H-Allen/HackTheBurgh/batfpga/confusion_matrix.png

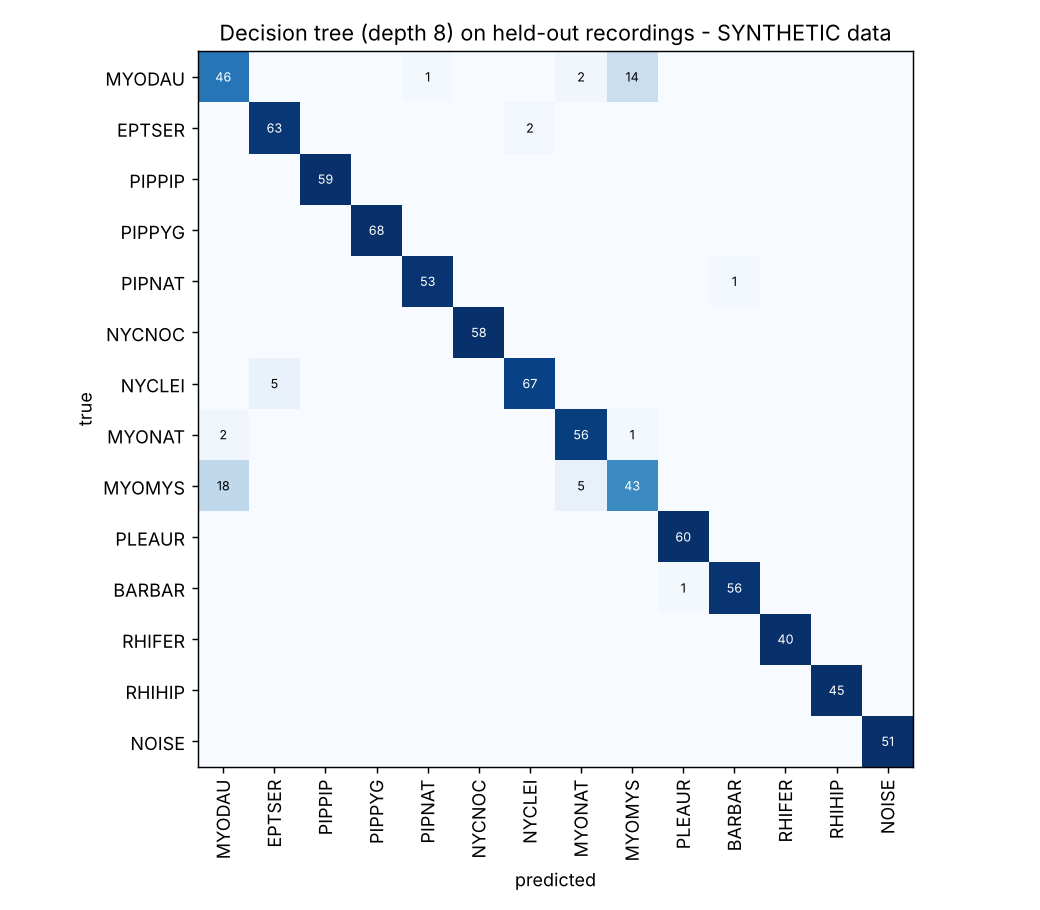
batfpga/confusion_matrix.png
