H-Allen/HackTheBurgh/batfpga/demo/presentation_audio/spectrogram_before_after.png

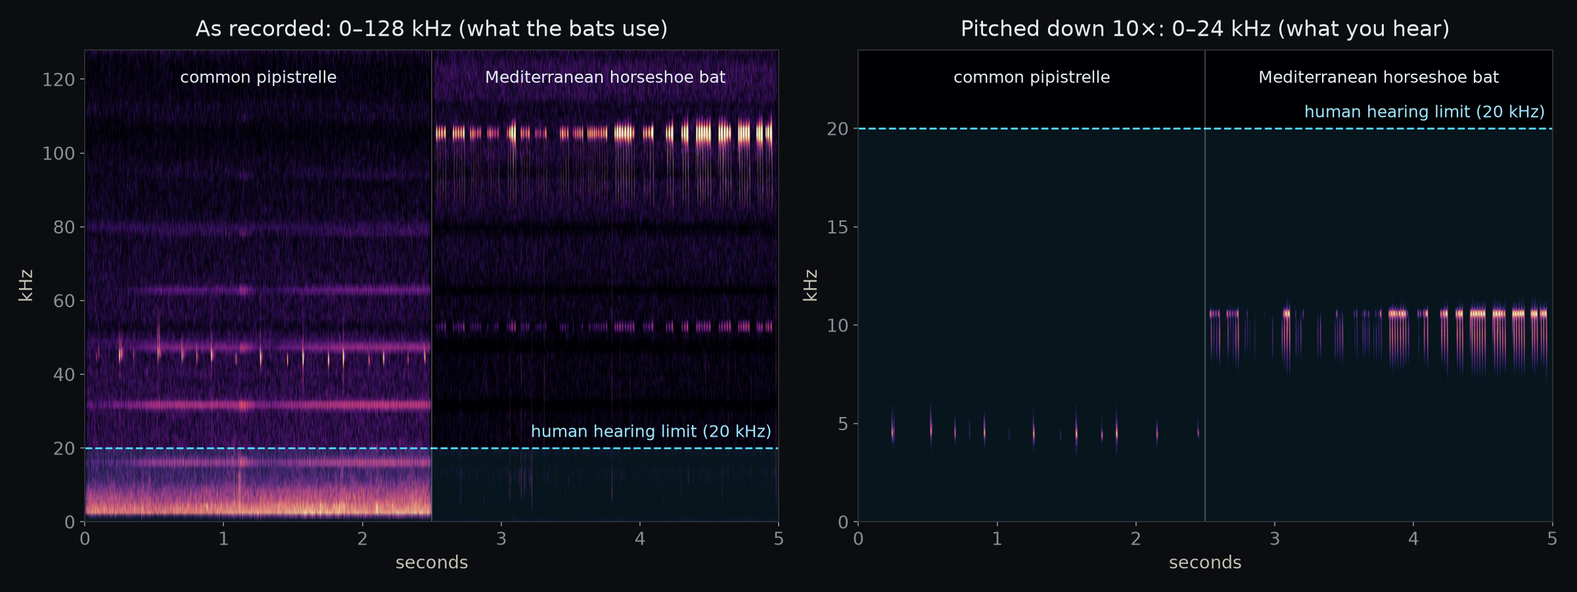
batfpga/demo/presentation_audio/spectrogram_before_after.png
