H-Allen/HackTheBurgh/batfpga/predict/figures/balkans/1_known_now.png

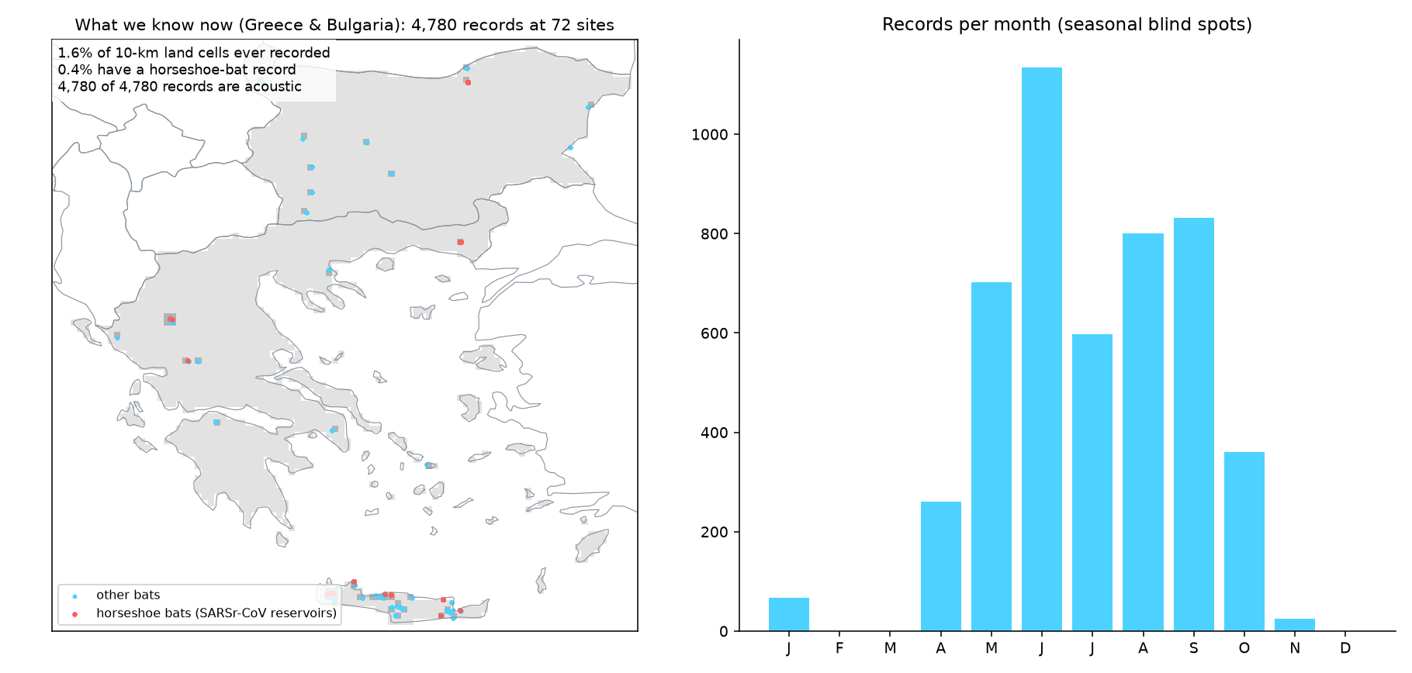
batfpga/predict/figures/balkans/1_known_now.png
