H-Allen/HackTheBurgh/batfpga/predict/figures/balkans/2_maps.png

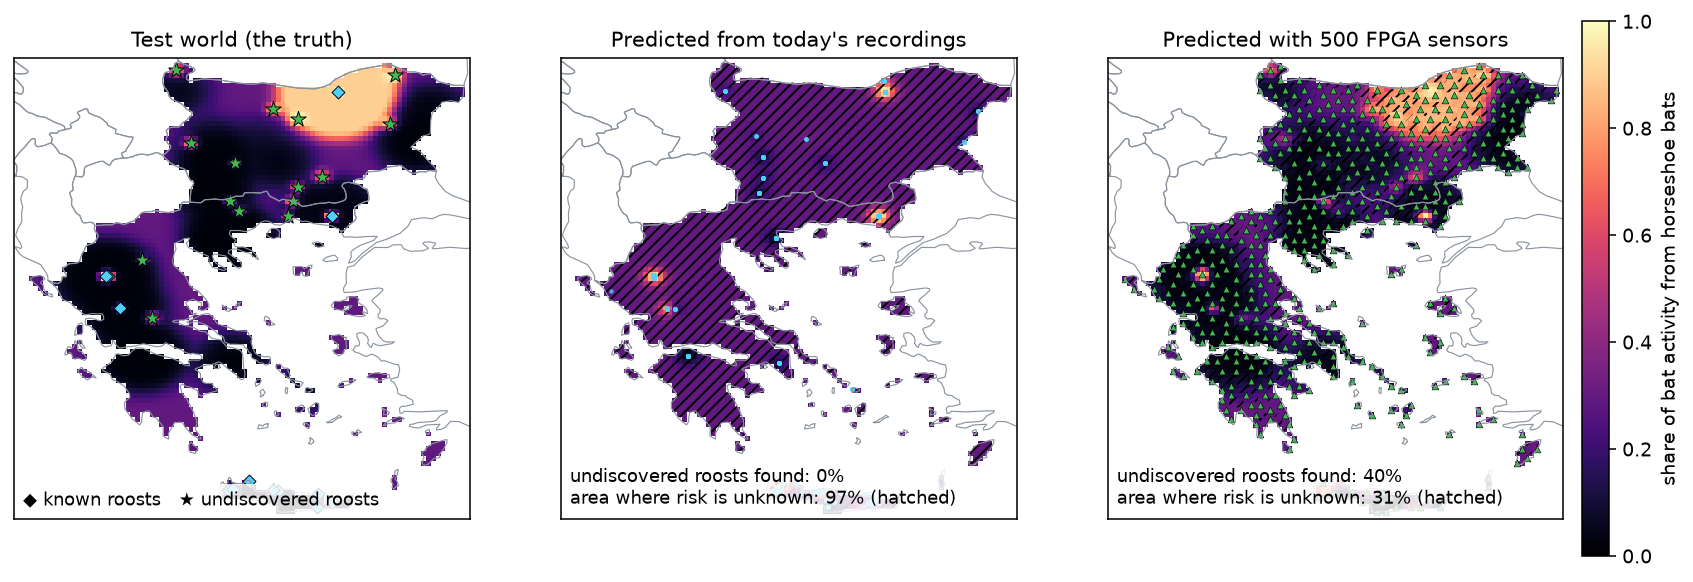
batfpga/predict/figures/balkans/2_maps.png
