H-Allen/HackTheBurgh/batfpga/predict/figures/balkans/3_curves.png

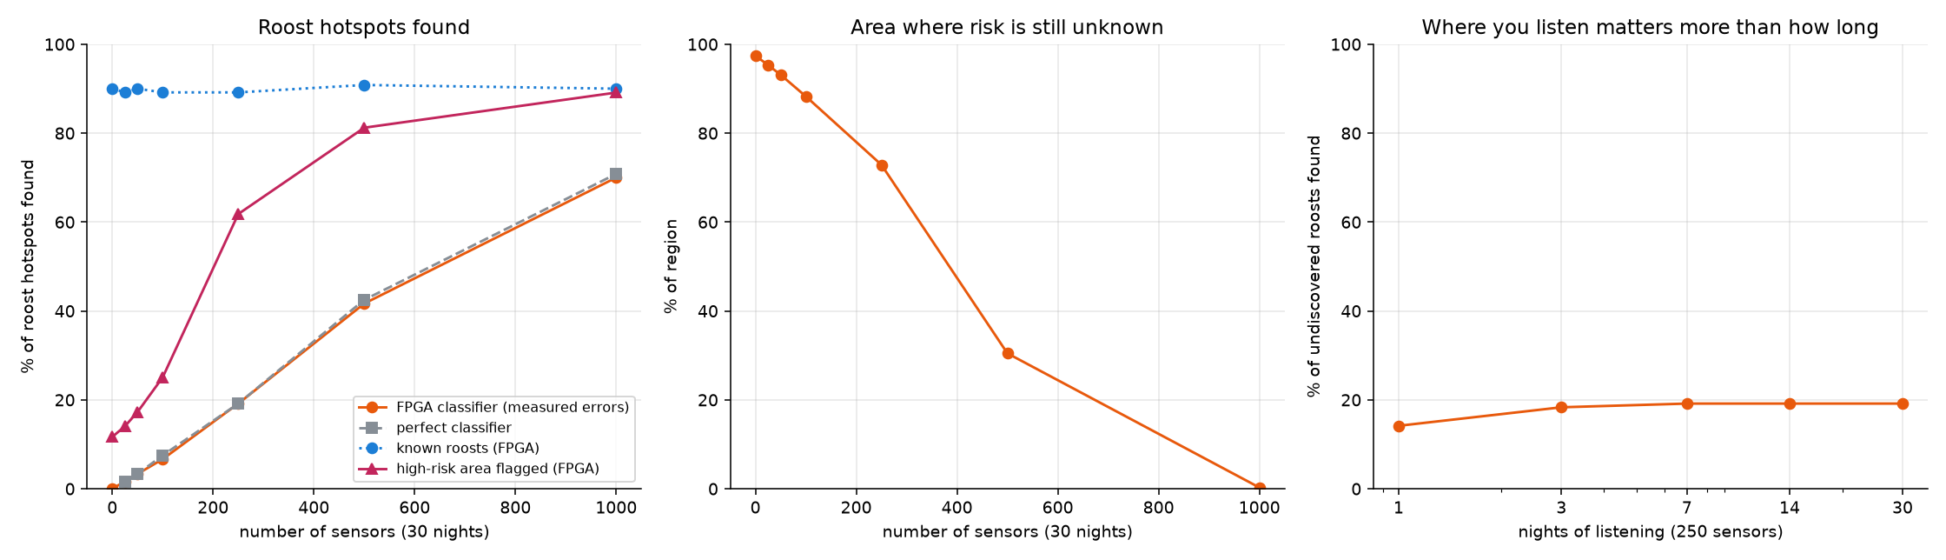
batfpga/predict/figures/balkans/3_curves.png
