H-Allen/HackTheBurgh/batfpga/predict/figures/sea/1_known_now.png

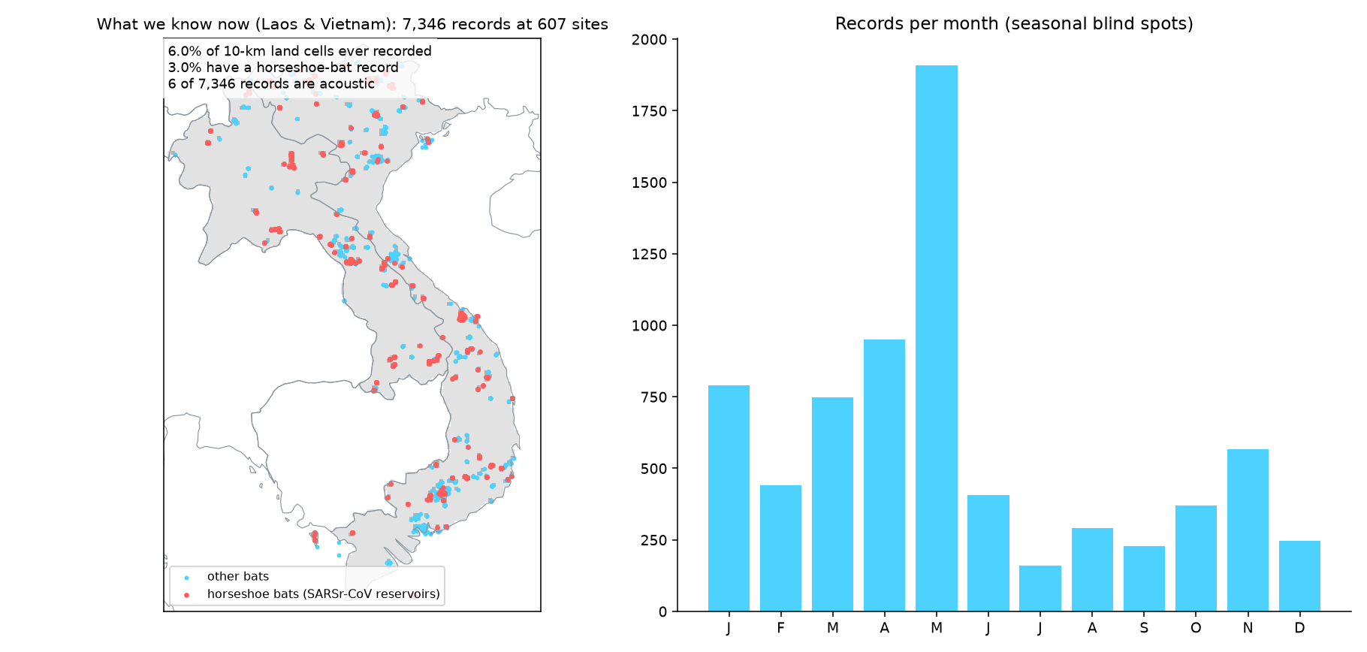
batfpga/predict/figures/sea/1_known_now.png
