H-Allen/HackTheBurgh/batfpga/predict/figures/sea/2_maps.png

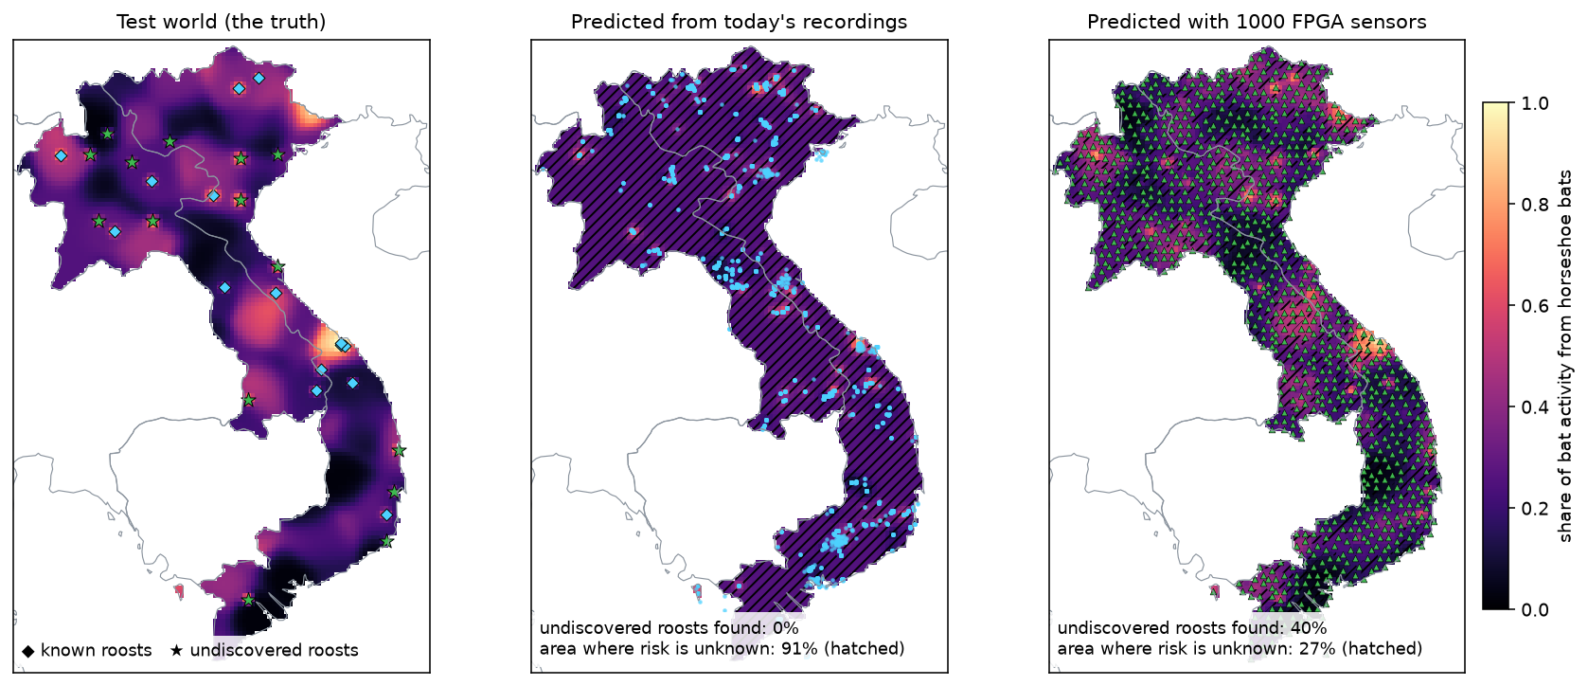
batfpga/predict/figures/sea/2_maps.png
