H-Allen/HackTheBurgh/batfpga/predict/figures/sea/3_curves.png

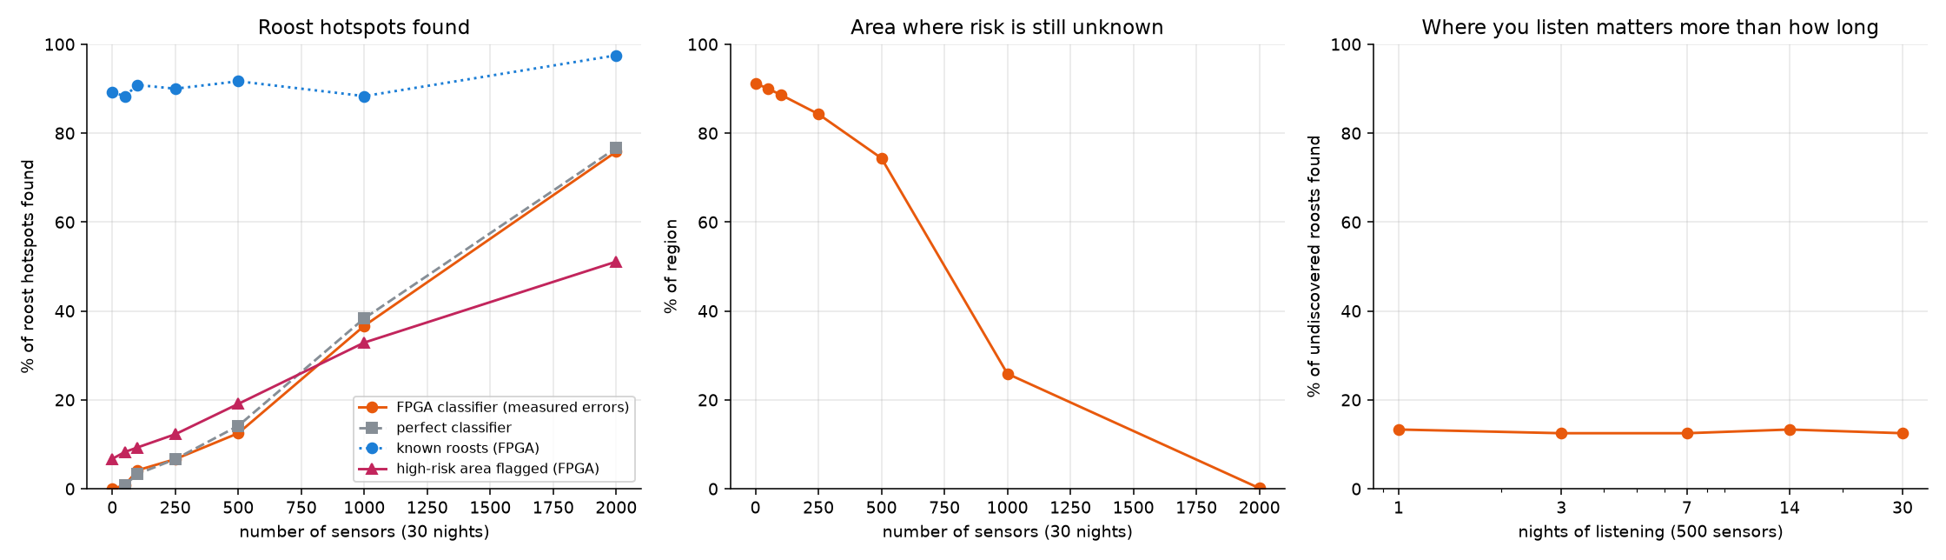
batfpga/predict/figures/sea/3_curves.png
