H-Allen/HackTheBurgh/batfpga/predict/viz/export/balkans/1_today.png

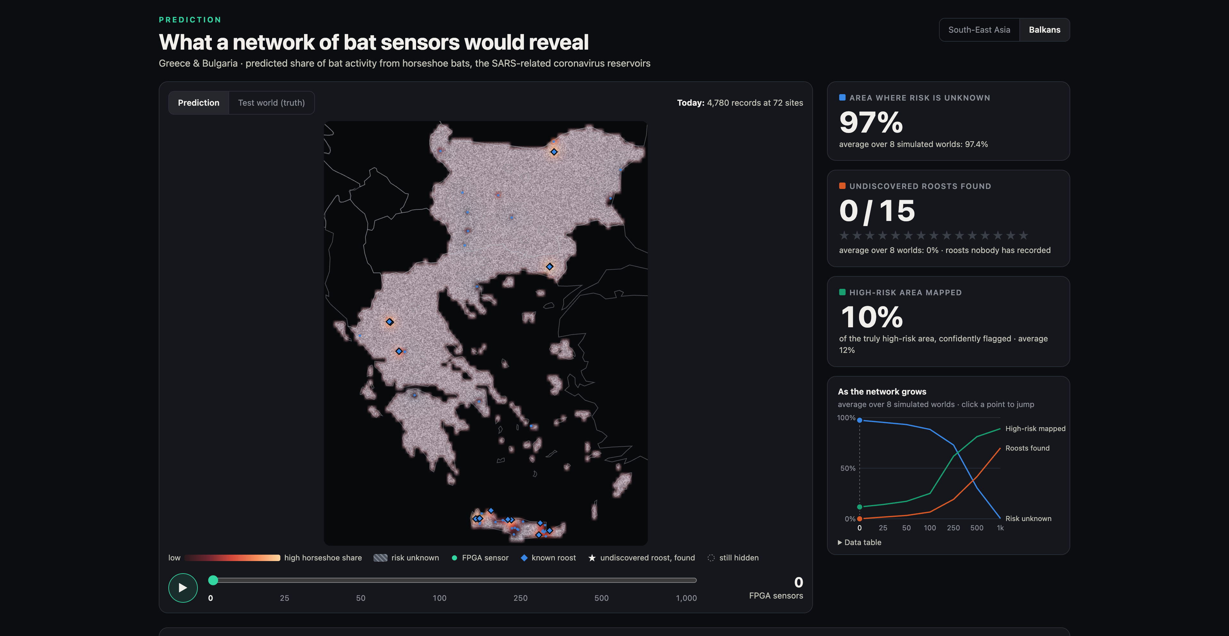
batfpga/predict/viz/export/balkans/1_today.png
