H-Allen/HackTheBurgh/batfpga/predict/viz/export/balkans/5_truth.png

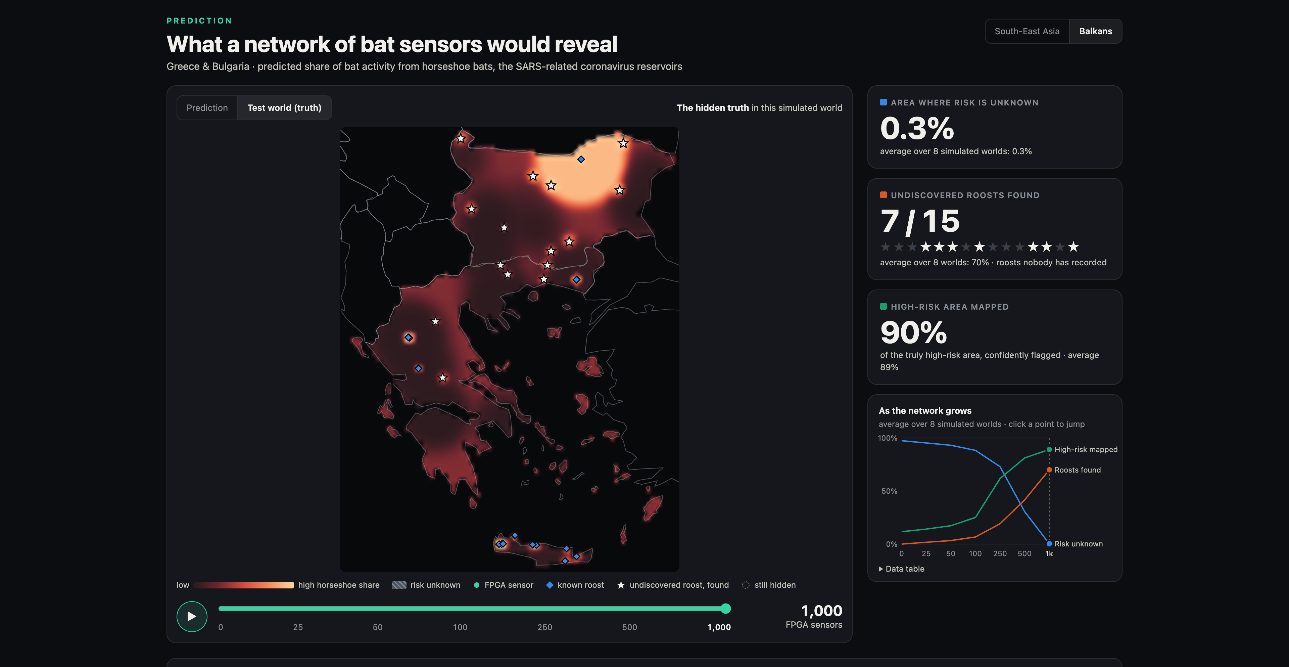
batfpga/predict/viz/export/balkans/5_truth.png
