H-Allen/HackTheBurgh/batfpga/predict/viz/export/balkans/network_reveal.gif

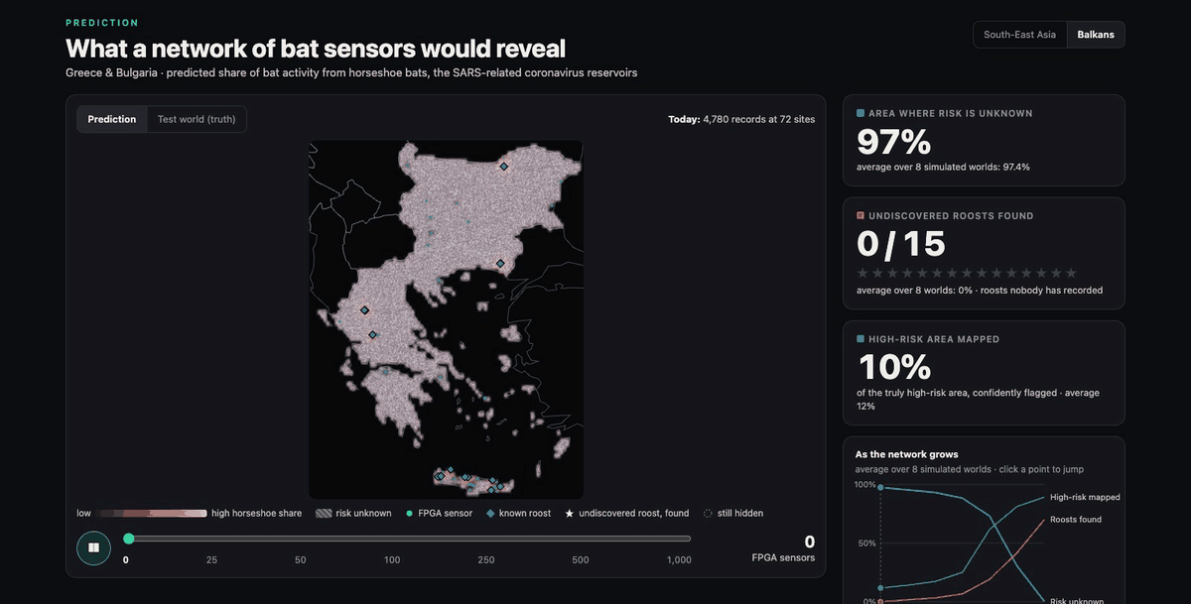
batfpga/predict/viz/export/balkans/network_reveal.gif
