H-Allen/HackTheBurgh/batfpga/predict/viz/export/sea/1_today.png

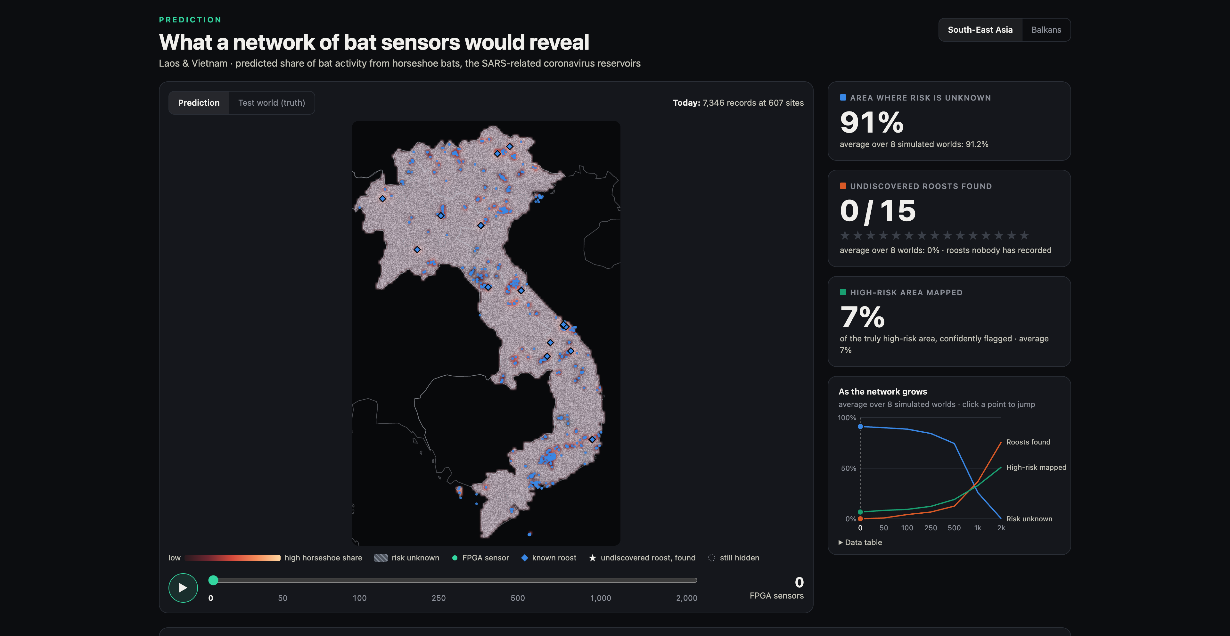
batfpga/predict/viz/export/sea/1_today.png
