H-Allen/HackTheBurgh/batfpga/predict/viz/export/sea/network_reveal.gif

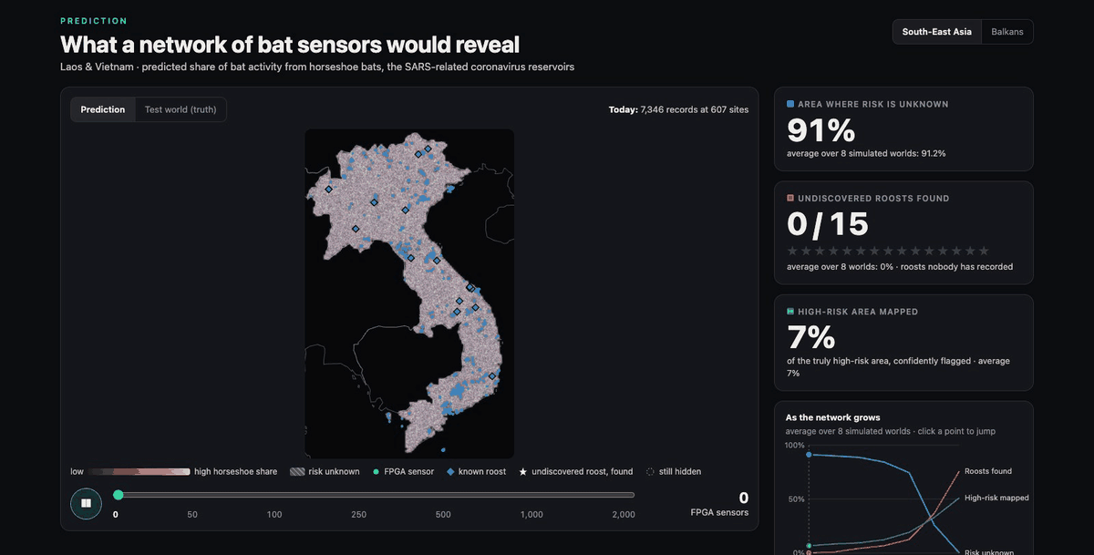
batfpga/predict/viz/export/sea/network_reveal.gif
