H-Allen/HackTheBurgh/(commit log)

2026-11-07 batfpga: Verilator testbench passes bit-exact (46/46 events), lint-clean RTL
    [confusion_matrix.csv]
2026-11-07 batfpga: low-power iterative 256-pt FFT core, bit-exact model, full-chain Verilator test
    fft256.v: 1 butterfly, 4 mults, 1 dual-port RAM, 3456 cycles/frame (real time at 3.5 MHz).
    fft_model.py is bit-exact with the RTL and within 2 LSB of bat_model.fft_mags().
    make sim_top: 512000 bins and 46/46 events bit-exact; 46/46 identical to float-FFT reference.
2026-11-07 batfpga: programmable decision tree (tree_walker.v + golden/tree.hex)
    Retraining now only needs a new tree.hex loaded at run time, no new bitstream.
    make sim_tree: walker == generated bat_tree.v on 200k vectors (incl. all thresholds).
    PROG_TREE=0 default keeps the fixed tree; sim and sim_top still pass bit-exact.
    [bat_features.v, bat_top.v, fft256.v, tb_bat.cpp, tb_top.cpp, tb_tree.cpp, tree_eq.v]
2026-11-07 batfpga: PYNQ AXI wrapper (DMA audio in, AXI-Lite tree/events/counters) + system test
    make sim_axi: run_bat.py register sequence in Verilator, 46/46 events bit-exact.
2026-11-07 batfpga: Vivado build script, board run_bat.py + serial_reader.py, make sdcard
    run_bat.py (on PYNQ): loads overlay + tree.hex, DMA audio, prints CSV per call, self-test.
    vivado/build.tcl: PS7 + AXI DMA + bat_axi at 50 MHz, reports util/timing/power (untested in Vivado).
    make test: all four Verilator tests PASS.
2026-11-07 batfpga: step-by-step board guide (PuTTY, Vivado build, SD card, on-board test)
2026-11-07 batfpga: all RAMs via sdp_ram.v (Vivado UG901 simple dual-port template)
    Fixes Vivado 2022.2 [Synth 8-2914] Unsupported RAM template at fft256.v:36: the FFT work RAM
    had two write ports. Now two copies of a 1-write/1-read RAM sharing one write port; butterfly
    writes split over two cycles (4480 cycles/frame, real time at 4.5 MHz, 11x at 50 MHz).
    tree_walker table and bat_axi event FIFO use sdp_ram too. FFT arithmetic unchanged:
    make test all PASS bit-exact.
    [bat_axi.v, fft256.v, sdp_ram.v, tree_walker.v]
2026-11-07 batfpga: export real ChirosetEurope tree; demo/golden audio from held-out test recordings
    export_fpga.py: classes from tree.pkl, risk groups from risk_groups.json, --audio WAV for golden
    vectors, asserts hardware limits (<=15 classes, <=512 nodes, depth <=8).
    make_demo.py: one 256 kHz clip per species from the manifest's test split.
    REAL data tree: 12 classes, 143 nodes, depth 8. make test: 74/74 events bit-exact on real audio.
    overlay/: lab-built bitstream (Vivado 2022.2) + reports, so it is not lost.
    [confusion_matrix.csv]
2026-11-07 batfpga: demo ground truth (demo_truth.csv) + run_bat.py --truth shows true species per call
    Board files unchanged (golden regenerated byte-identical). On the held-out demo clips the
    REAL-data tree labels 54/74 calls correctly (Python model = FPGA bit-exact).
    [demo_truth.csv]
2026-11-08 batfpga: live demo UI (laptop plays audio, FPGA classifies same clip from SD over serial)
    run_bat.py --serve: load overlay once, preload clips, PLAY <wav> <speed> streams paced at
    real time x speed (10 = time-expanded), prints START/CSV/END. One-shot mode unchanged.
    demo/demo_ui.py + index.html: stdlib web server + pyserial; spectrogram with live FPGA
    detection boxes, risk-group alerts, accuracy vs recording label; real-time and 10x slowed
    playback; auto login/sudo/launch on the board; --fake mode for testing without a board.
    Tested end to end through a pty with a real shell and mock pynq.
2026-11-08 batfpga demo: --fake uses the bit-exact Python model for every clip; Windows console fix
    [demo_ui.py]
2026-11-08 batfpga demo: classifier switch, pitched-down mode (same timing), 15 s demo mix, Stop
    - Pitched down: frequency division /10 re-synthesis, keeps timing so the board runs at real speed
    - FPGA classifier on/off switch; spectrogram revealed as it plays; human-hearing band shaded;
    ground-truth labels hidden while the classifier is off; keyboard shortcuts for the presenter
    - make_demo.py: demo_mix.wav (15 s, 12 species, several held-out recordings each) + truth
    - run_bat.py --serve: STOP command; demo_ui: /api/stop, <clip>_truth.csv, audio-failure fallback
    - golden self-test files unchanged. Python-model labels on the 15 s mix: 154/199 (real data)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
    [demo_ui.py, run_bat.py]
2026-11-08 demo: 21 s mix (6 species, one pass each, 1.2 s pauses); Now-hearing vote, tally, risk counter
    - make_demo.py: --mix-species/--mix-per/--mix-gap; densest 2.5 s window of one held-out
    recording per species (chosen by call activity, not classifier result); short-recording fallback
    - UI: no per-call ticks/crosses; 'Now hearing' = confidence-weighted vote over last 1.5 s;
    'Detected in this recording' tally; risk-group-correct as the headline metric
    - pitch-down render ignores digital-silence gaps when estimating the noise floor
    - real data, bit-exact model: 146/164 species, 148/164 risk group on the new mix
    [demo_ui.py]
2026-11-08 batfpga: track the board/demo bundle sdcard/batfpga_eu (bitstream, tree, clips, run_bat.py)
    So the Windows demo laptop gets everything with git pull; it is also the folder to copy to the SD card.
    [demo_mix_truth.csv, demo_truth.csv]
2026-11-08 predict: what we know now vs what an FPGA sensor network would let us predict (OSSE)
    Real ChirosetEurope records for Greece & Bulgaria (4,780 recordings at 72 sites, 1.6% of
    10-km land cells ever recorded); test worlds of horseshoe-bat (SARSr-CoV reservoir) share
    with known and undiscovered roosts; Gaussian-process prediction with uncertainty; sensors use
    the classifier's measured error rates. Simulated: unknown area 97% -> 30% (500 sensors) -> 1%
    (1000); undiscovered roosts found 0% -> 47% -> 77%; FPGA errors ~ perfect classifier.
2026-11-08 predict: interactive 'fog of war' visual of the sensor network + slide exports
    predict/viz/index.html (offline, opens from file): network grows 0 -> 1000 FPGA sensors, uncertainty
    fog clears, undiscovered roosts revealed, live counters + curve; truth toggle; keys space/arrows/T.
    Exports: 1080p@2x stills per stage and network_reveal.gif. Simulation now uses a nested
    space-filling sensor layout (numbers ~unchanged: unknown area 97% -> 30% @500 -> 0.3% @1000).
2026-11-08 demo: proof it's the real FPGA - LIVE/SIMULATED badge, raw serial console, hardware counters; generic title
    run_bat.py --serve prints STATS <samples> <cycles> <fft_busy> <fclk> from the FPGA registers after each PLAY;
    the page shows them (cycles/frame, clock, real-time capacity). Title: 'Bat Call Classifier'.
2026-11-08 predict: South-East Asia (Laos & Vietnam) as the default region, from GBIF bat occurrence records
    7,346 GBIF records (161 species, 1,882 horseshoe bats, only 6 acoustic) at 607 sites = 6% of
    10-km land cells. Same OSSE: unknown area 91% today -> 26% (1,000 sensors) -> 0.1% (2,000);
    undiscovered roosts 0% -> 37% -> 76%. SE Asia assumes a classifier retrained on local calls with
    our measured accuracy. Visual has a South-East Asia / Balkans switch; per-region figures,
    results, stills and GIFs. GBIF.org occurrence data accessed 2026-11-08.
    [gbif_chiroptera_LA_VN.csv]
